wrink/wrink-hw/rpi-nrf52840-hat/jlcpcb-lib/lcsc_footprints.csv

lcsc | refs | value | status | footprint_files
C1647 | C2,C3 | 18pF | ok | C0603.kicad_mod
C23138 | R1,R2,R3,R4,R5,R6,R7,R8,R12,R13,R15 | 330Ω | ok | R0603.kicad_mod
C23162 | R9,R10,R11,R14 | 4.7kΩ | ok | (existing or shared footprint)
C356849 | U1 | E73-2G4M08S1C | ok | WIRELM-SMD_E73-2G4M08S1C.kicad_mod
C7462182 | X1 | 32.768kHz 12.5pF | ok | CRYSTAL-SMD_L3.2-W1.5-1.kicad_mod
C7496855 | D1 | RGB_CA | ok | LED-SMD_4P-L1.6-W1.5_P4-1615G2B2R4TS2-06T-001-24.kicad_mod
C18723546 | U2 | 24C32 | ok | SOP-8_L4.9-W3.9-P1.27-LS6.0-BL.kicad_mod
C19725278 | J2 | Raspberry_Pi_4 | ok | HDR-TH_40P-P2.54-V-F-R2-C20-S2.54.kicad_mod
C20416422 | C1,C5 | 4.7uF | ok | C0805.kicad_mod
C41413841 | J1,J3 | Conn_02x04_Odd_Even | ok | HDR-TH_8P-P2.54-V-M-R2-C4-S2.54.kicad_mod
