wrink/wrink-hw/rpi-nrf52840-hat/rpi-nrf52840-hat.kicad_pcb

## KiCad design rpi-nrf52840-hat/rpi-nrf52840-hat.kicad_pcb (2026-10-11)

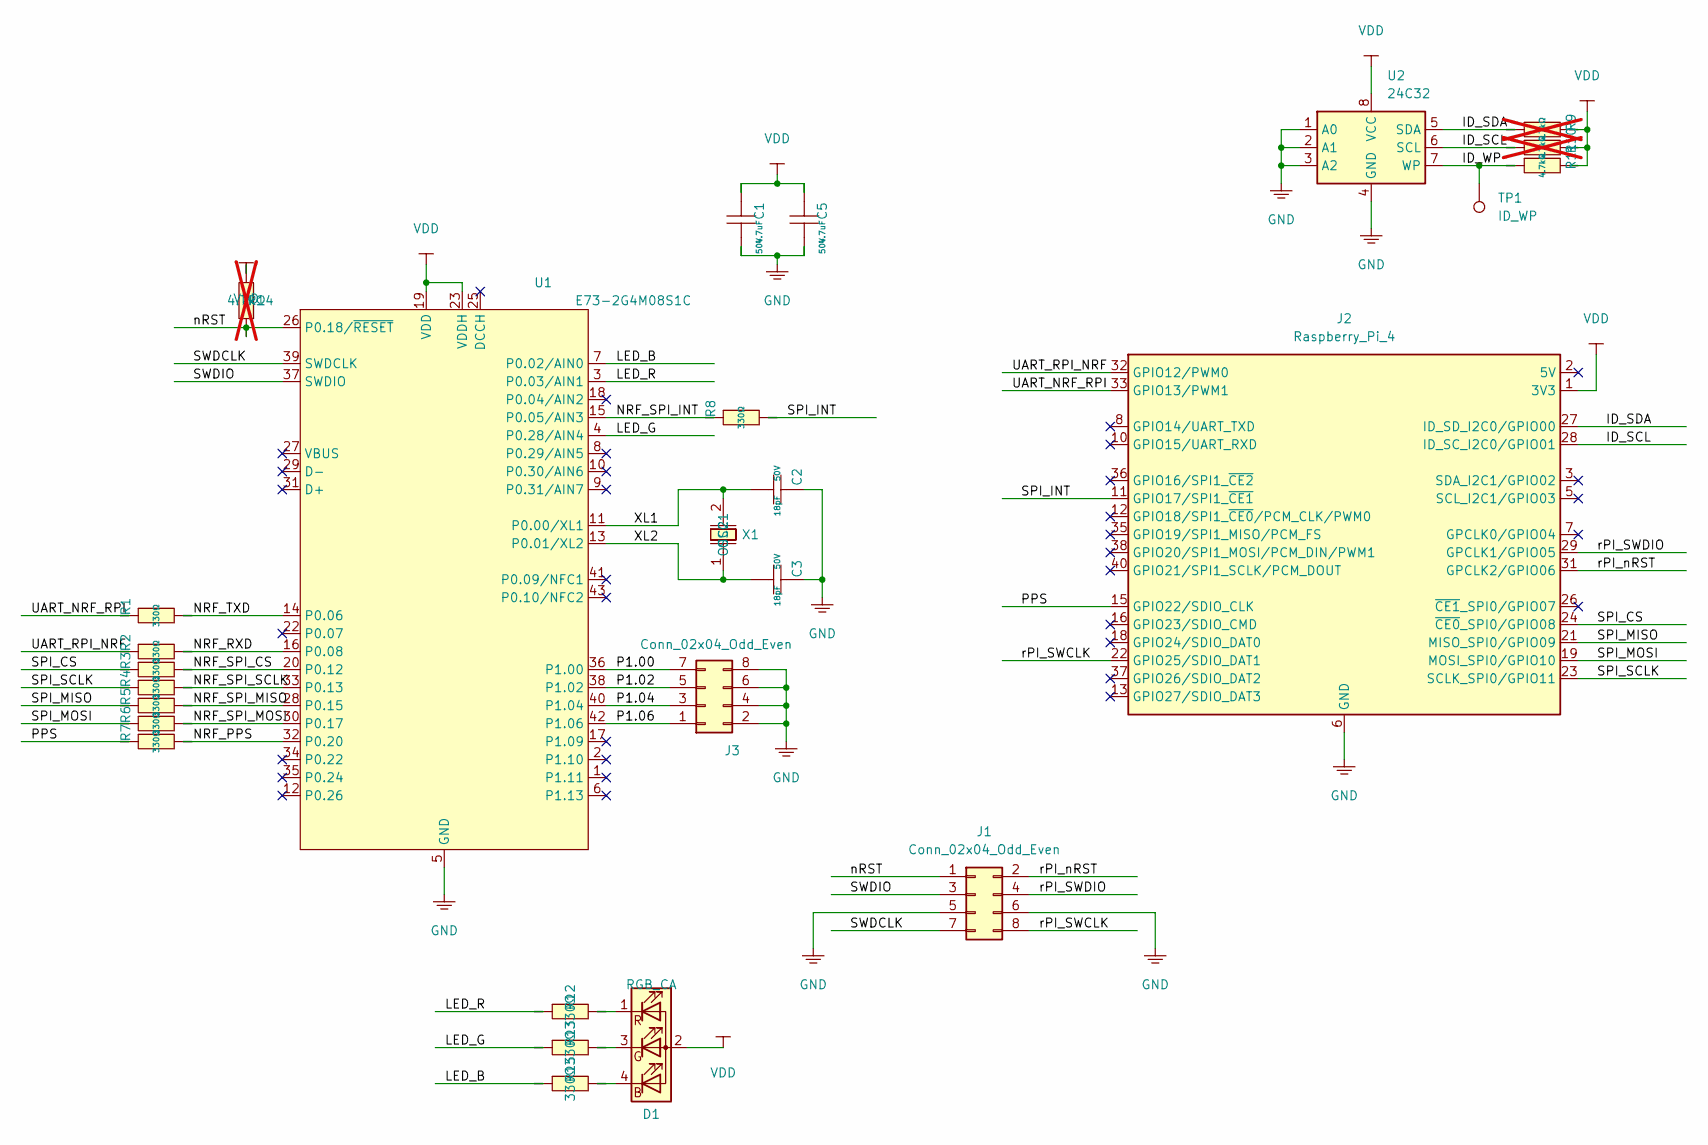
[picture p3: schematic rpi-nrf52840-hat.kicad_sch, nRF52840 HAT]

Parts:
C1, C5: 4.7uF; C0805; Voltage Rated 50V; Tolerance ±10%; Part TCC0805X7R475K500FT; LCSC C20416422
C2, C3: 18pF; C0603; Voltage Rated 50V; Tolerance ±5%; Part CL10C180JB8NNNC; LCSC C1647
D1: RGB_CA; LED_RGB_1.6x1.5mm_CA_P4-1615; MPN P4-1615G2B2R4TS2-06T-001-24; LCSC C7496855
J1, J3: Conn_02x04_Odd_Even; PinHeader_2x04_P2.54mm_Vertical; MPN A254UP-ZS04P; LCSC C41413841
J2: Raspberry_Pi_4; PinSocket_2x20_P2.54mm_Vertical; MPN HDGCPH2.54-PZS-2X20; LCSC C19725278
R1, R2, R3, R4, R5, R6, R7, R8, R12, R13, R15: 330Ω; R0603; MPN 0603WAF3300T5E; LCSC C23138
R9, R10, R14: 4.7kΩ; R0603; MPN 0603WAF4701T5E; LCSC C23162; not fitted
R11: 4.7kΩ; R0603; MPN 0603WAF4701T5E; LCSC C23162
TP1: ID_WP; PinHeader_1x01_P2.54mm_Vertical
U1: E73-2G4M08S1C; WIRELM-SMD_E73-2G4M08S1C; LCSC C356849
U2: 24C32; SOP-8_L4.9-W3.9-P1.27-LS6.0-BL; MPN 24C32BN(XBLW); LCSC C18723546
X1: 32.768kHz 12.5pF; CRYSTAL-SMD_L3.2-W1.5-1; Frequency Tolerance ±20ppm; Part CC7V-T1A-32.768KHZ-12.5PF-20PPM-TA-QC; LCSC C7462182

Connections:
/ID_SCL: J2.28 (ID_SC_I2C0/GPIO01), R10.1, U2.6 (SCL)
/ID_SDA: J2.27 (ID_SD_I2C0/GPIO00), R9.1, U2.5 (SDA)
/ID_WP: R11.1, TP1.1 (1_1), U2.7 (WP)
/LED_B: R15.1, U1.7 (P0.02/AIN0)
/LED_G: R13.1, U1.4 (P0.28/AIN4)
/LED_R: R12.1, U1.3 (P0.03/AIN1)
/NRF_PPS: R7.2, U1.32 (P0.20)
/NRF_RXD: R2.2, U1.16 (P0.08)
/NRF_SPI_CS: R3.2, U1.20 (P0.12)
/NRF_SPI_INT: R8.1, U1.15 (P0.05/AIN3)
/NRF_SPI_MISO: R5.2, U1.28 (P0.15)
/NRF_SPI_MOSI: R6.2, U1.30 (P0.17)
/NRF_SPI_SCLK: R4.2, U1.33 (P0.13)
/NRF_TXD: R1.2, U1.14 (P0.06)
/P1.00: J3.7, U1.36 (P1.00)
/P1.02: J3.5, U1.38 (P1.02)
/P1.04: J3.3, U1.40 (P1.04)
/P1.06: J3.1, U1.42 (P1.06)
/PPS: J2.15 (GPIO22/SDIO_CLK), R7.1
/SPI_CS: J2.24 (~CE0_SPI0/GPIO08), R3.1
/SPI_INT: J2.11 (GPIO17/SPI1_~CE1), R8.2
/SPI_MISO: J2.21 (MISO_SPI0/GPIO09), R5.1
/SPI_MOSI: J2.19 (MOSI_SPI0/GPIO10), R6.1
/SPI_SCLK: J2.23 (SCLK_SPI0/GPIO11), R4.1
/SWDCLK: J1.7, U1.39 (SWDCLK)
/SWDIO: J1.3, U1.37 (SWDIO)
/UART_NRF_RPI: J2.33 (GPIO13/PWM1), R1.1
/UART_RPI_NRF: J2.32 (GPIO12/PWM0), R2.1
/XL1: C2.2, U1.11 (P0.00/XL1), X1.2
/XL2: C3.2, U1.13 (P0.01/XL2), X1.1
/nRST: J1.1, R14.2, U1.26 (P0.18/~RESET)
/rPI_SWCLK: J1.8, J2.22 (GPIO25/SDIO_DAT1)
/rPI_SWDIO: J1.4, J2.29 (GPCLK1/GPIO05)
/rPI_nRST: J1.2, J2.31 (GPCLK2/GPIO06)
GND: C1.2, C2.1, C3.1, C5.2, J1.5, J1.6, J2.6 (GND), J2.9 (GND), J2.14 (GND), J2.20 (GND), J2.25 (GND), J2.30 (GND), J2.34 (GND), J2.39 (GND), J3.2, J3.4, J3.6, J3.8, U1.5 (GND), U1.21 (GND), U1.24 (GND), U2.1 (A0), U2.2 (A1), U2.3 (A2), U2.4 (GND)
unnamed: D1.4 (BK), R15.2
unnamed: D1.3 (GK), R13.2
unnamed: D1.1 (RK), R12.2
VDD: C1.1, C5.1, D1.2 (A), J2.1 (3V3), J2.17 (3V3), R9.2, R10.2, R11.2, R14.1, U1.19 (VDD), U1.23 (VDDH), U2.8 (VCC)

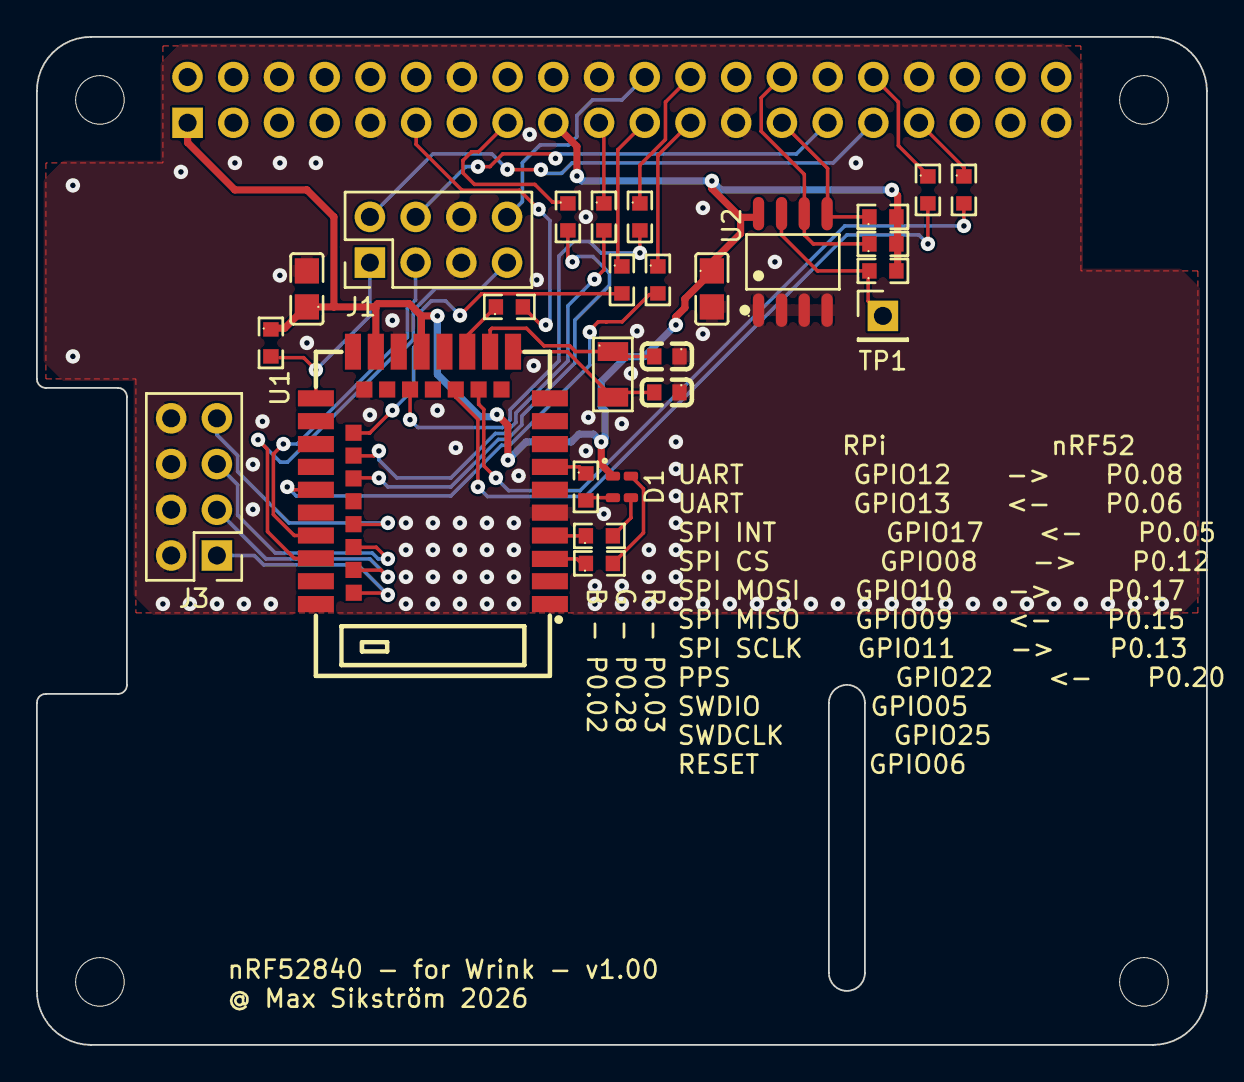
[picture p4: board rpi-nrf52840-hat.kicad_pcb from above]

Board: 2 copper layers, 65.0 x 56.0 mm, 31 parts (1 on the bottom side), 39 nets.

Other parts of the board:
MH1, MH2, MH3, MH4: MountingHole_2.7mm_M2.5
