wrink/wrink-hw/(commit log)

2026-10-10 Add library to sync footprints from jlcpcb
2026-10-10 Add tool to generate gerber files
